manuelcecchetto/talking-8ball/shots/cad-back.jpg

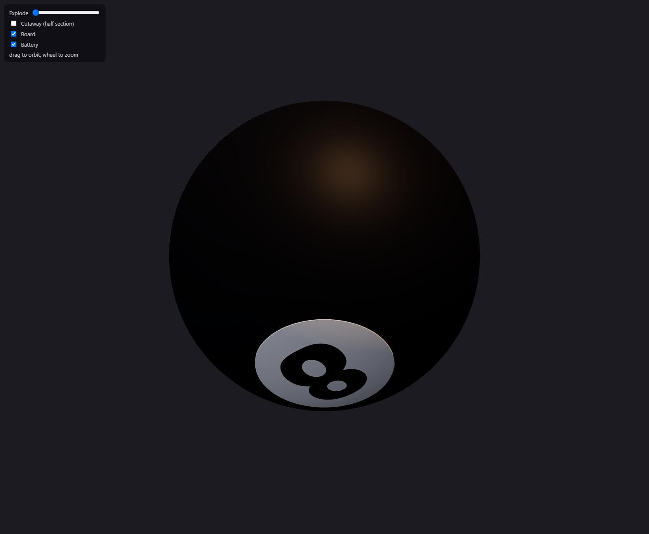
shots/cad-back.jpg
