manuelcecchetto/talking-8ball/shots/cad-front-inside.jpg

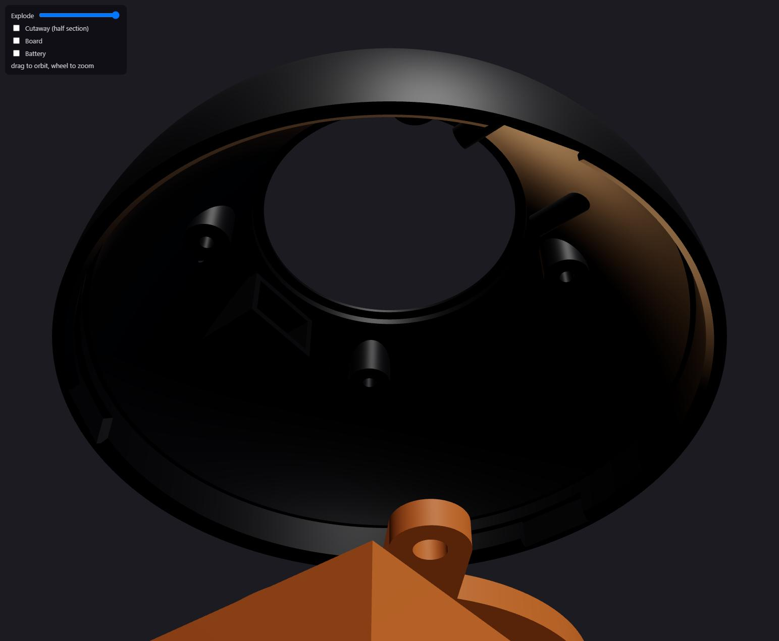
shots/cad-front-inside.jpg
