manuelcecchetto/talking-8ball/shots/cad-usb.jpg

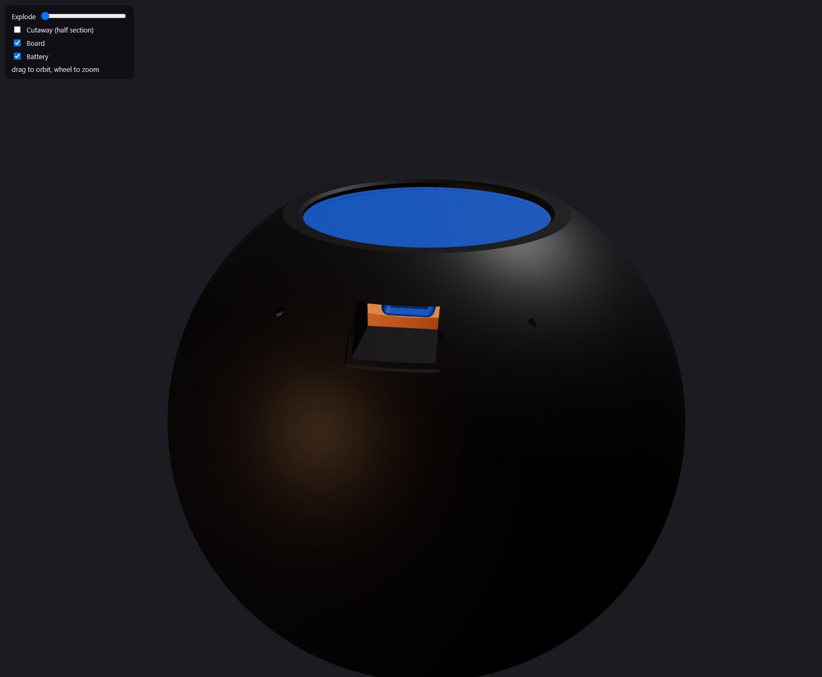
shots/cad-usb.jpg
