manuelcecchetto/talking-8ball/shots/front-supports.png

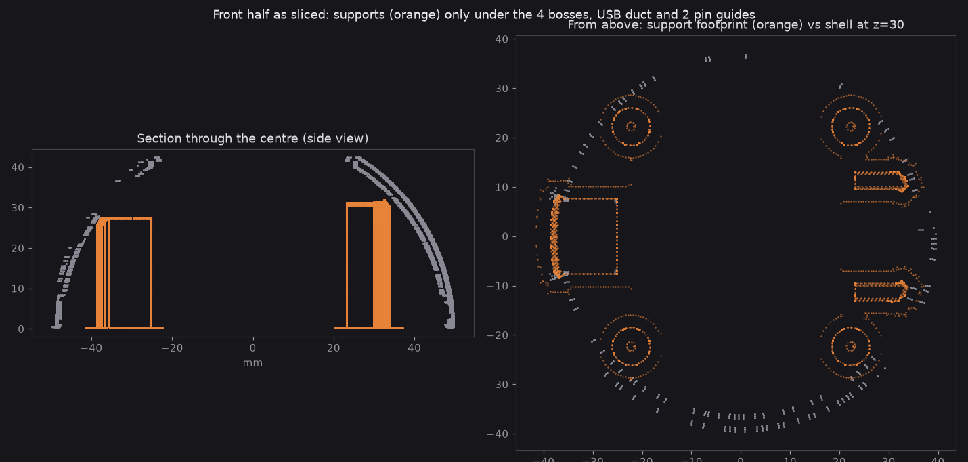
shots/front-supports.png
