manuelcecchetto/talking-8ball/shots/live-typed.jpg

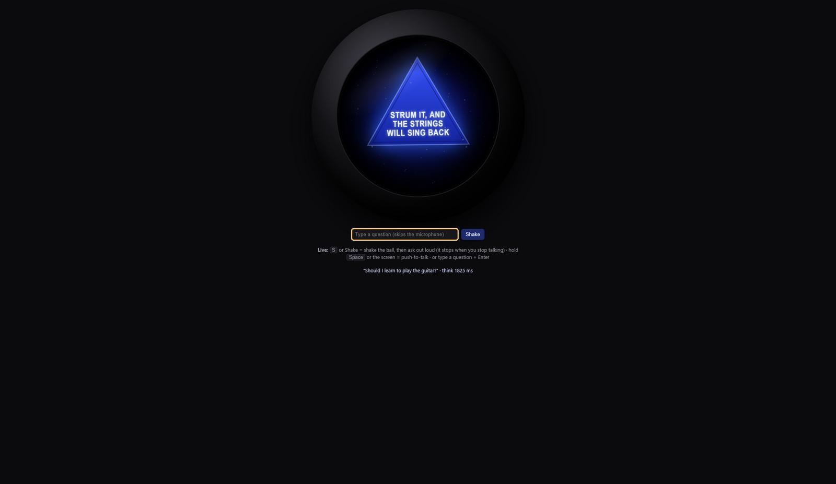
shots/live-typed.jpg
