manuelcecchetto/talking-8ball/out/asm_battery.stl

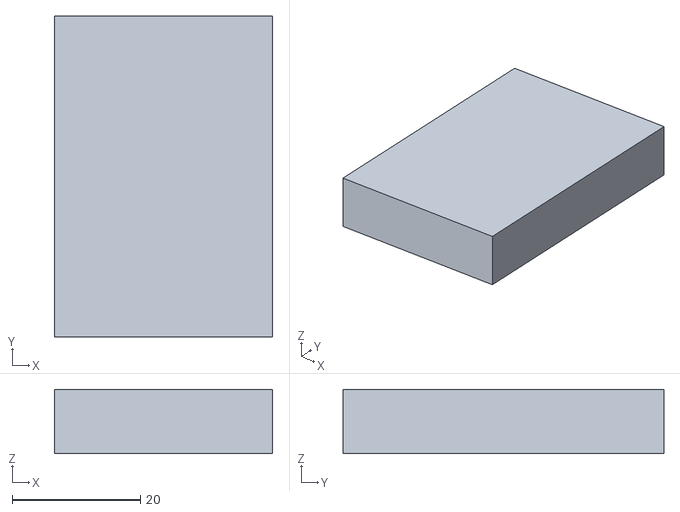
[picture p16: CAD file, 2026-10-15]
out/asm_battery.stl
34.0 x 50.0 x 10.0
