manuelcecchetto/talking-8ball/out/asm_chassis.stl

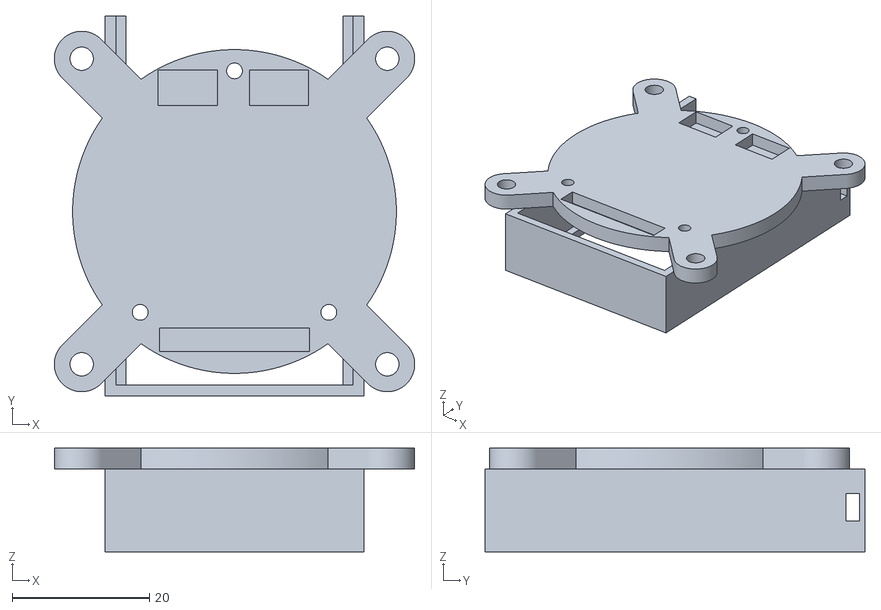
[picture p17: CAD file, 2026-10-15]
out/asm_chassis.stl
52.5 x 55.4 x 15.1
