manuelcecchetto/talking-8ball/out/assembly.step

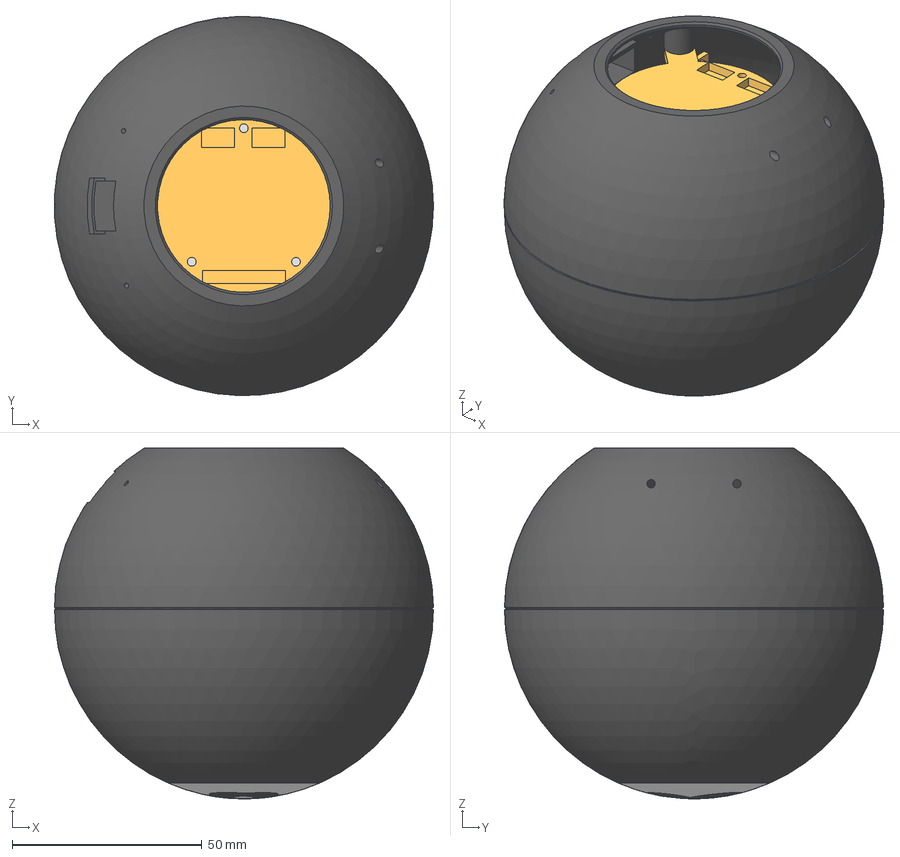
[picture p18: CAD file, 2026-10-15]
out/assembly.step
99.9 x 100.0 x 92.5 mm
front_half
back_half
chassis
eight_disc
eight_ink
battery_103450
