manuelcecchetto/talking-8ball/out/asm_eight_ink.stl

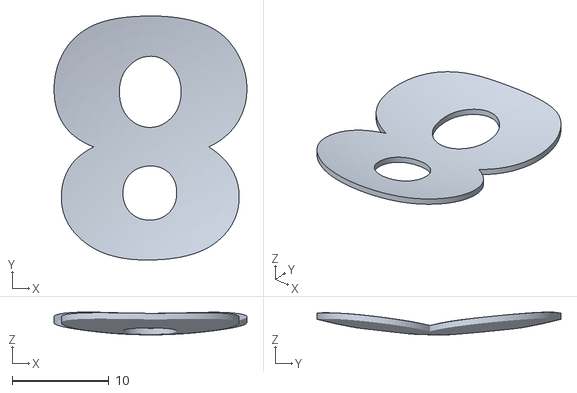
[picture p19: CAD file, 2026-10-15]
out/asm_eight_ink.stl
19.9 x 25.2 x 2.35
