manuelcecchetto/talking-8ball/out/asm_back_half.stl

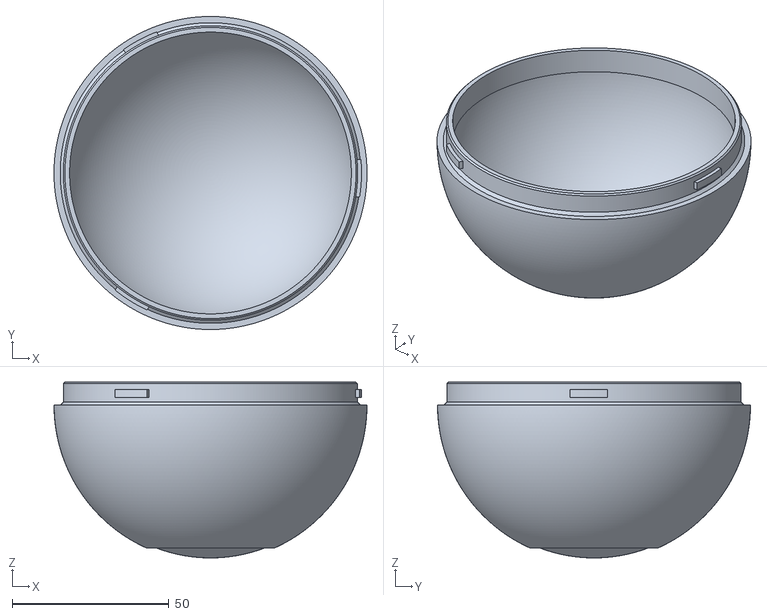
[picture p20: CAD file, 2026-10-15]
out/asm_back_half.stl
100.0 x 100.0 x 56.2
