manuelcecchetto/talking-8ball/out/asm_eight_disc.stl

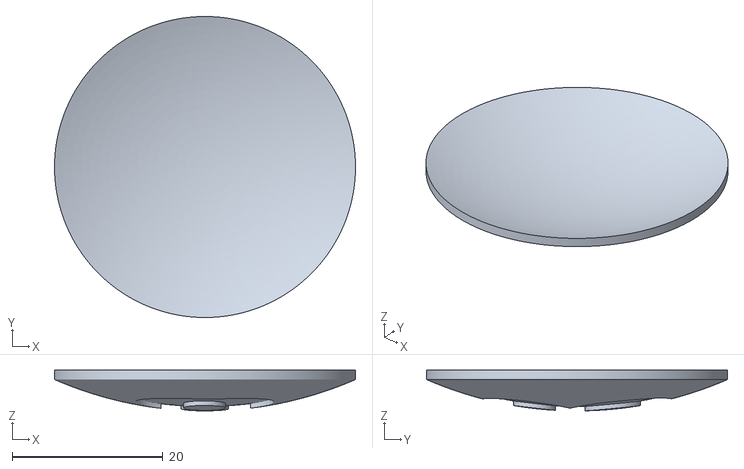
[picture p21: CAD file, 2026-10-15]
out/asm_eight_disc.stl
40.0 x 40.0 x 5.42
