manuelcecchetto/talking-8ball/out/asm_front_half.stl

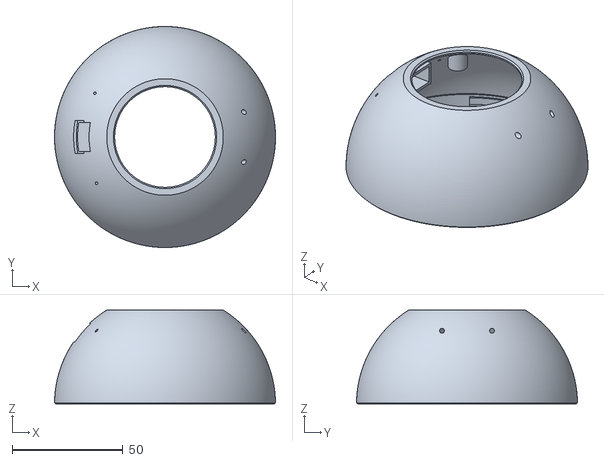
[picture p22: CAD file, 2026-10-15]
out/asm_front_half.stl
100.0 x 100.0 x 42.5
