manuelcecchetto/talking-8ball/out/test_seam_back.stl

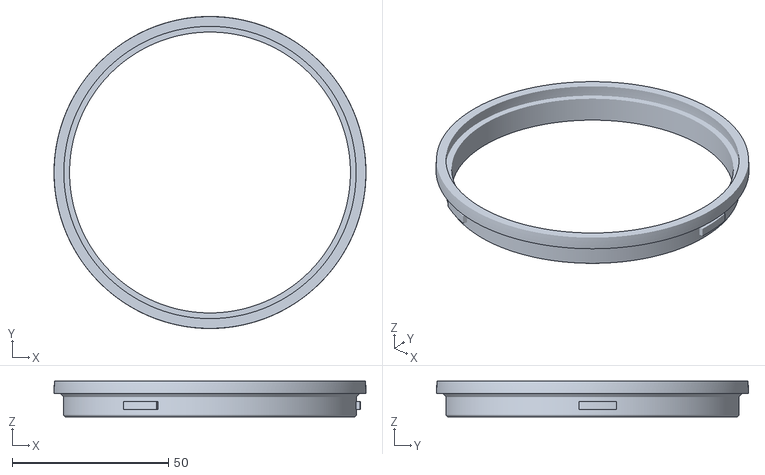
[picture p23: CAD file, 2026-10-15]
out/test_seam_back.stl
100.0 x 100.0 x 11.4
