manuelcecchetto/talking-8ball/print/bambu/p2s/1_test_rings.gcode.3mf

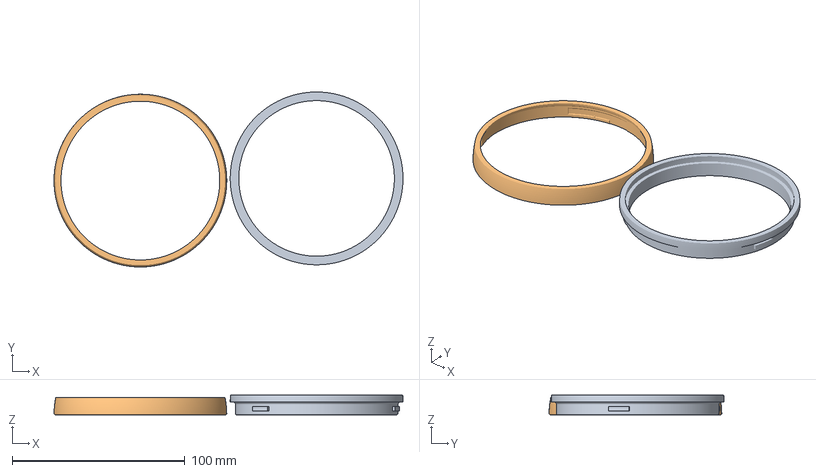
[picture p24: CAD file, 2026-10-17]
print/bambu/p2s/1_test_rings.gcode.3mf
202.0 x 101.3 x 11.4 mm
test_seam_back
test_seam_front
