manuelcecchetto/talking-8ball/print/bambu/a1mini/1_test_rings.gcode.3mf

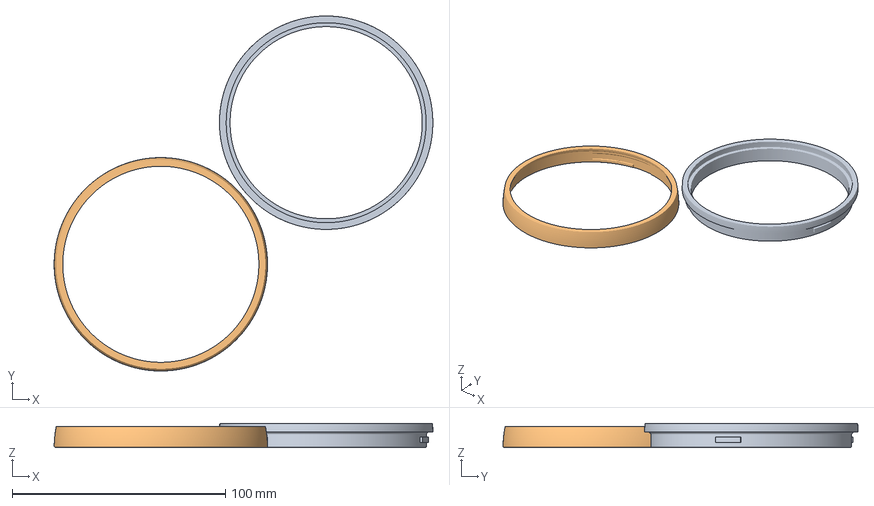
[picture p25: CAD file, 2026-10-17]
print/bambu/a1mini/1_test_rings.gcode.3mf
177.5 x 166.3 x 11.4 mm
test_seam_back
test_seam_front
