manuelcecchetto/talking-8ball/print/1_test_rings.3mf

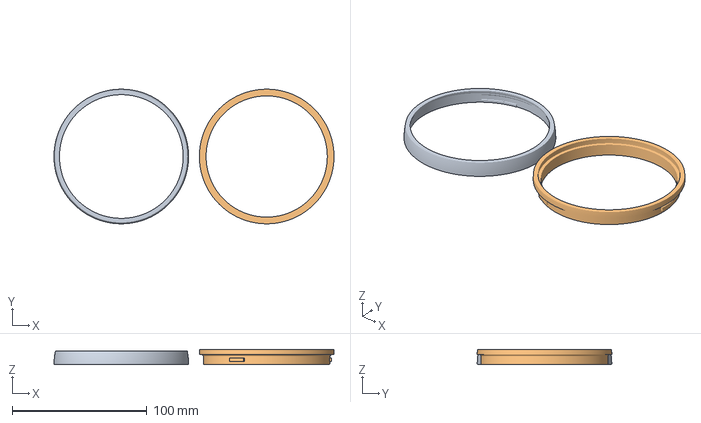
[picture p26: CAD file, 2026-10-15]
print/1_test_rings.3mf
208.0 x 100.0 x 11.4 mm
test_seam_front
test_seam_back
