manuelcecchetto/talking-8ball/print/bambu/a1mini/4_chassis_stand.gcode.3mf

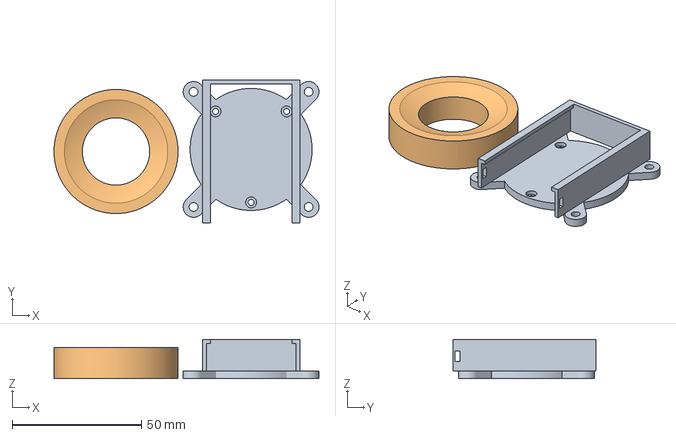
[picture p27: CAD file, 2026-10-17]
print/bambu/a1mini/4_chassis_stand.gcode.3mf
102.5 x 55.4 x 15.1 mm
chassis
stand
