manuelcecchetto/talking-8ball/print/4_chassis_stand.3mf

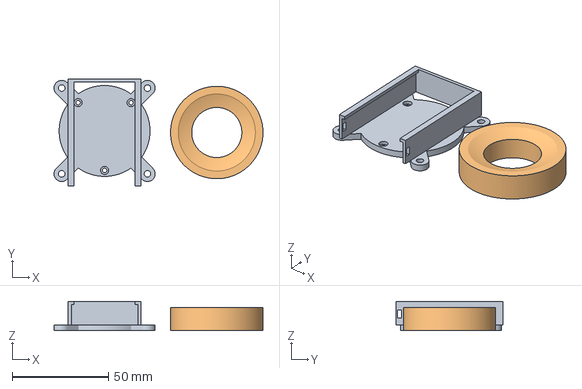
[picture p28: CAD file, 2026-10-15]
print/4_chassis_stand.3mf
108.5 x 55.4 x 15.1 mm
chassis
stand
