manuelcecchetto/talking-8ball/out/test_seam_front.stl

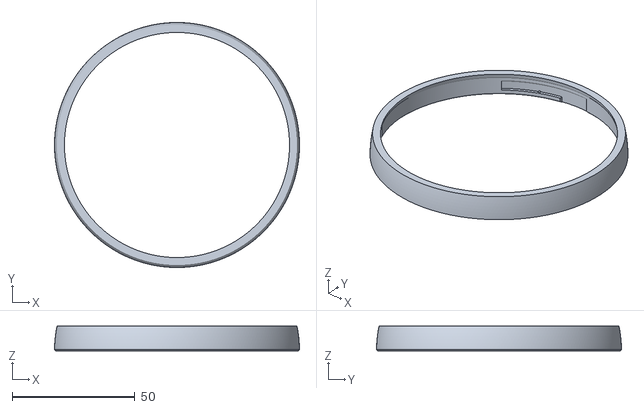
[picture p29: CAD file, 2026-10-15]
out/test_seam_front.stl
100.0 x 100.0 x 10.00
