manuelcecchetto/talking-8ball/out/stand.stl

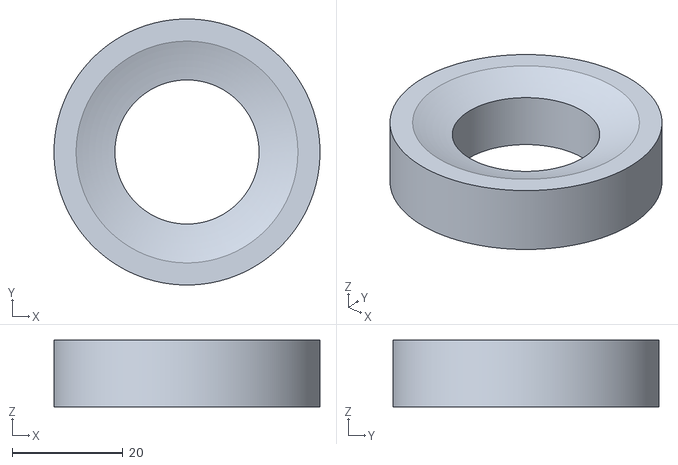
[picture p30: CAD file, 2026-10-15]
out/stand.stl
48.0 x 48.0 x 12.0
