manuelcecchetto/talking-8ball/(list of files, cad)

Other CAD files:
print/5_eight_disc.3mf
print/bambu/a1mini/3_back_half.gcode.3mf
out/front_half.stl
print/2_front_half.3mf
print/bambu/p2s/3_back_half.gcode.3mf
print/3_back_half.3mf
print/bambu/a1mini/2_front_half.gcode.3mf
print/bambu/p2s/2_front_half.gcode.3mf
out/chassis.stl
print/bambu/p2s/5_eight_disc.gcode.3mf
out/eight_disc_white.stl
print/bambu/a1mini/5_eight_disc.gcode.3mf
print/bambu/p2s/4_chassis_stand.gcode.3mf
out/back_half.stl
out/eight_ink_black.stl
