manuelcecchetto/talking-8ball/shots/cad-assembled.jpg

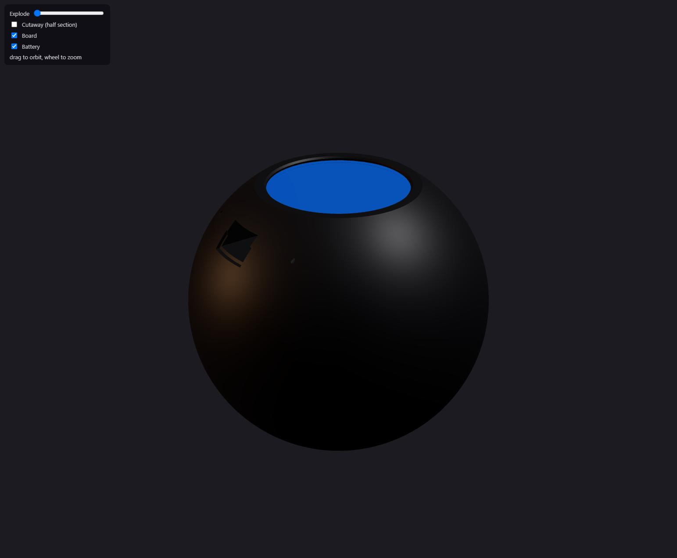
shots/cad-assembled.jpg
