manuelcecchetto/talking-8ball/(commit log)

2026-10-15 Talking 8-ball: parametric shell and internals, print jobs, reveal animation
    [1_test_rings.3mf, 2_front_half.3mf, 3_back_half.3mf, 4_chassis_stand.3mf, 5_eight_disc.3mf, asm_back_half.stl, asm_battery.stl, asm_chassis.stl]
2026-10-17 Bambu A1 mini and P2S print jobs: sliced projects with painted supports, checked
    [1_test_rings.gcode.3mf, 2_front_half.gcode.3mf, 3_back_half.gcode.3mf, 4_chassis_stand.gcode.3mf, 5_eight_disc.gcode.3mf]
2026-10-24 Firmware for the ball: own compositor for the screen (4.5 -> 30-60 fps), shake, mics, Wi-Fi, offline answers
    The ESP32-S3 firmware (ESP-IDF 5.5, Waveshare BSP): scene, motion, voice, net, console, answers,
    plus tools/ballctl.py for logs, console commands and screenshots over USB.
    The screen started on LVGL at 4.5 fps: too many invalidated areas made it redraw everything every
    frame, through PSRAM buffers. scene.c now composes only the changed rectangles into two internal-RAM
    DMA strips on both cores, from each item's last-committed state; LVGL only renders the answer
    triangle off screen. Also: no false shake at boot, screenshots no longer corrupted by log lines.
    [partitions.csv]
2026-10-24 Shake: count strong-acceleration slices instead of summed jerk; ballctl streams logs
    Measured on the ball: real shakes put 4-10 of ten 100 ms slices over 1.5 g beyond gravity, normal
    handling (pick up, turn, walk, put down) at most 1. The old summed-jerk trigger fired on handling.
    ballctl.py now prints the log as it arrives and survives the port vanishing, so a crash report
    before a reset is kept.
    [ballctl.py, motion.c]
2026-10-24 The answer stays level with real up; bubbles rise that way
    The accelerometer gives up across the screen; past a 5 degree dead zone the resting triangle eases
    to it, rising and sinking follow it too. While turning it samples one pixel per pixel (23-27 fps,
    up from 11), then redraws bilinear when still. A turned triangle is damaged as 16-row bands of its
    shape plus glow instead of its bounding box (185k -> 110k px per frame).
    [app.h, motion.c, scene.c]
2026-10-24 No hop when the answer finishes rising or starts sinking
    The rise ended dead centre while the resting answer sags up to 10 px toward the low side, so it
    jumped on the first resting frame; the sink started from the centre again. Both now meet the
    resting spot.
    [scene.c]
2026-10-24 Bigger answer triangle (300 -> 370 px) and bigger text; fix the sink
    The triangle's corners now sit 214 px from the centre, the most that clears the round rim, and
    the text layout starts at 68 px instead of 56. The die deep in the liquid keeps its 90 px size.
    Also restores the sink's shrink and turn, lost when the previous commit merged them into a
    comment.
    [scene.c]
